ngochuyhuynh/ECG-Signal-Acquisition/hardware/Schematic.pdf

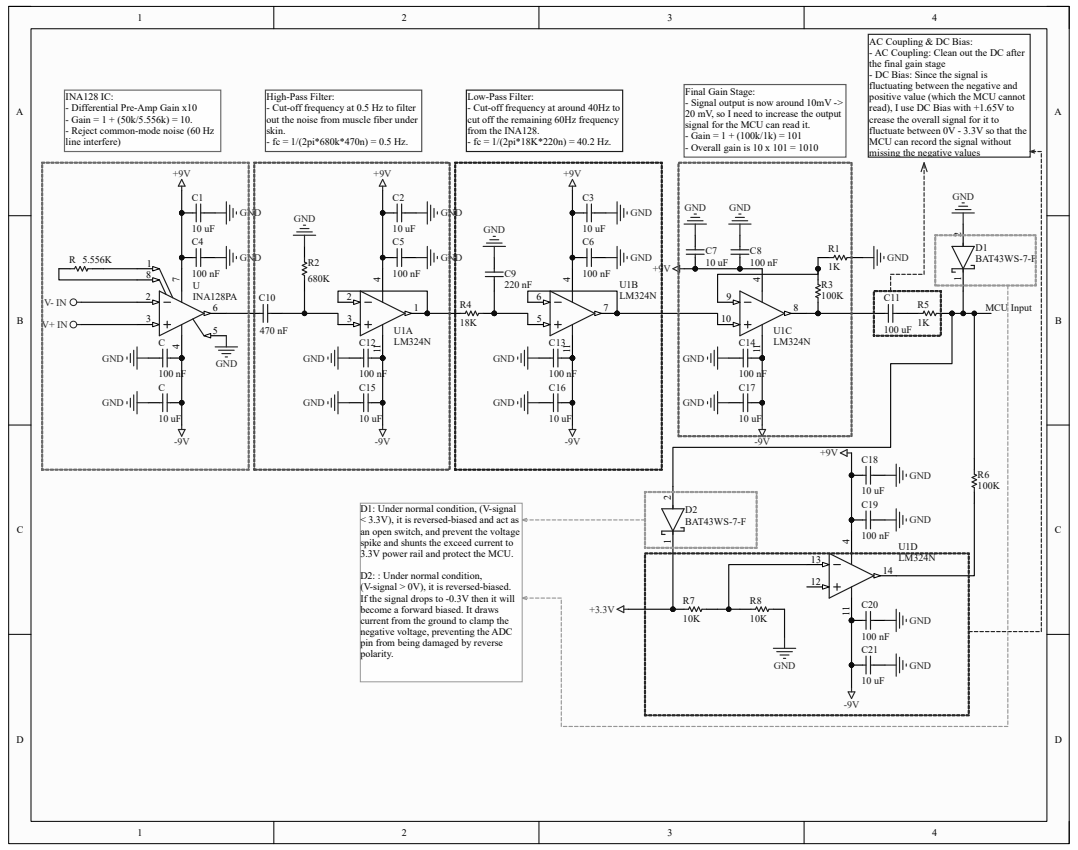
[picture p3: page 1]

AC Coupling & DC Bias:
- AC Coupling: Clean out the DC after
the final gain stage
- DC Bias: Since the signal is
fluctuating between the negative and
positive value (which the MCU cannot
read), I use DC Bias with +1.65V to
crease the overall signal for it to
fluctuate between 0V - 3.3V so that the
MCU can record the signal without
missing the negative values

INA128 IC:
- Differential Pre-Amp Gain x10
- Gain = 1 + (50k/5.556k) = 10.
- Reject common-mode noise (60 Hz
line interfere)

High-Pass Filter:
- Cut-off frequency at 0.5 Hz to filter
out the noise from muscle fiber under
skin.

Low-Pass Filter:
- Cut-off frequency at around 40Hz to
cut off the remaining 60Hz frequency
from the INA128.

Final Gain Stage:
- Signal output is now around 10mV ->
20 mV, so I need to increase the output
signal for the MCU can read it.
- Gain = 1 + (100k/1k) = 101
- Overall gain is 10 x 101 = 1010

D1: Under normal condition, (V-signal
< 3.3V), it is reversed-biased and act as
an open switch, and prevent the voltage
spike and shunts the exceed current to
3.3V power rail and protect the MCU.

D2: : Under normal condition,
(V-signal > 0V), it is reversed-biased.
If the signal drops to -0.3V then it will
become a forward biased. It draws
current from the ground to clamp the
negative voltage, preventing the ADC
pin from being damaged by reverse
polarity.
